devilreraser/hw_crypto_miner_bitfury/BitFury/Project Outputs for SHA256/BitFury BOM 2013 10 02.xls

Comment | Description | Designator | Footprint | LibRef | Quantity
Yellow SML210YT ROHM |  | D6 | SMD_0805_LED2012X100N | LED_2 | 1
SLC1480-201MLD |  | L1, L2 | SMD_INDM12501250X800A - Coilcraft SLC1480 | L | 2
Red SML210VT ROHM |  | D4 | SMD_0805_LED2012X100N | LED_2 | 1
Q4.000 MHz HC-49SM SMD | Crystal | Y1 | SMD_HC49_XTAL1140X480X420N | CRYSTAL | 1
Orange SML210DT ROHM |  | D7 | SMD_0805_LED2012X100N | LED_2 | 1
MCP2551-I/SN | CAN Driver | U21 | SMD_SOIC127P602X173-8N | MCP2551 | 1
LTC 4449 | Mosfet 12V Dual Bootstrapped PWM Sync Buck Optimised | U25, U30 | SMD_SOP65P490X110-9N - DUAL | DRVFET_LTC4442 | 2
L78M05CDT-TR |  | U20 | SMD_TO229P991X239-4AN_DPAK | IC_Vout1GND2Vin3 | 1
Green SML210MT ROHM |  | D5 | SMD_0805_LED2012X100N | LED_2 | 1
dsPIC33EP256MU806 |  | U1 | SMD_QFP50P1200X1200X120-64N | dsPIC33EP256MU806 | 1
CU04SCM15B0-R0 |  | J3 | SMD_CON-CVILUX-CU04-SCM15B0 | CON_USB_MINI_1 | 1
CON SIP2 | Connector | J4 | PTH_HDRV02W64P254_1X02 | CON2 | 1
CON MOLEX HDD |  | J2 | MOLEX_PWR_4P - AVALON | CON_4PINS | 1
CON FAN |  | J6 | PTH_CON_PANCON-MPSS100-04D | CON_4PINS | 1
CON CAN | Connector | J5 | PTH_CON_JST-B2PS-VH | CON2 | 1
BITFURY256 | BitFury SHA256 | U2, U3, U4, U5, U7, U8, U9, U10, U11, U12, U13, U14, U15, U16, U17, U18 | SMD_QFN50P700X700X90-49N | BITFURY256 | 16
BD33KA5WF |  | U19 | SMD_SOIC127P602X173-8N | IC_LM2931AD-5.0R2G_SO-8 | 1
BD18KA5WF |  | U24 | SMD_SOIC127P602X173-8N | IC_LM2931AD-5.0R2G_SO-8 | 1
BC817 |  | Q7, Q8 | SMD_SOT23_SOT95P240X120-3N | BJT_NPN_B1E2C3 | 2
BAT54C |  | D1, D2 | SMD_SOT23_SOT95P240X120-3N | D_DUAL_A1A2CC3 | 2
AP1RA03GMT-3 |  | Q1, Q2, Q3, Q4, Q5, Q6 | SMD_SON127P615X520X100-8N | MOS_N_D1_S1S2S3G4D5D6D7D8 | 6
768 | Resistor | R36 | SMD_0603_RESC1608X55N | Res3 | 1
470nF | Capacitor (Semiconductor SIM Model) | C2, C3, C4, C5, C6, C7, C8, C9, C11, C12, C13, C14, C15, C16, C18, C19, C20, C21, C22, C23, C24, C25, C26, C27, C28, C29, C30, C32, C33, C35, C36, C37, C39, C40, C41, C42, C43, C44, C46, C48, C49, C50, C51, C52, C53, C54, C55, C56, C57, C58, C60, C61, C62, C64, C66, C67, C68, C69, C70, C71, C77, C78, C79, C80, C81, C82, C83, C84, C87, C88, C89, C90, C91, C92, C93, C94, C95, C96, C97, C98, C100, C102, C103, C105, C106, C107, C108, C109, C110, C111, C112, C113, C114, C115, C116, C117, C118, C119, C120, C121, C122, C123, C124, C125, C126, C127, C128, C129, C130, C131, C132, C133, C134, C135, C136, C137, C138, C139, C140, C142, C144, C145, C146, C148, C149, C150, C152, C153, C154, C155, C156, C157, C158, C159, C160, C161, C162, C163, C164, C165, C166, C167, C169, C170, C171, C172, C173, C174, C175, C176, C177, C178, C179, C180, C181, C182, C183, C184, C185, C326, C327, C328, C329, C330, C331, C332, C333, C334, C335, C336, C337, C338, C339, C340, C341, C342, C343, C344, C345, C346, C347, C348, C349, C351, C352, C353, C355, C356, C388, C389, C390, C391, C392, C393, C394, C395, C396, C397, C398, C399, C400, C401, C402, C403, C404, C405, C406, C407, C408, C409, C410, C411, C412, C413, C414, C415, C416, C417, C418, C419, C420, C421, C422, C423, C424, C427, C428, C429, C430, C431, C432, C433, C434, C435, C436, C439, C440, C441, C442, C443, C444, C445, C446, C447, C448, C449, C450, C451, C452, C453, C454, C455, C456, C457, C458, C459, C460, C461, C462, C463, C464, C465, C466, C467, C4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 | SMD_0603_CAPC1608X80N | Cap Semi | 278
120 | Resistor | R41 | SMD_0603_RESC1608X55N | Res3 | 1
100pF | Capacitor | C253, C254 | SMD_0603_CAPC1608X80N | CAP | 2
100nF/50V | Capacitor | C189, C312 | SMD_0805_CAPC2012X145N | CAP | 2
100nF | Capacitor | C34, C72, C73, C74, C75, C76, C255 | SMD_0603_CAPC1608X80N | CAP | 7
27 | Resistor | R34, R35 | SMD_0603_RESC1608X55N | Res3 | 2
22uF/6.3V | Capacitor | C63, C198, C199, C200, C201, C202, C203, C204, C205, C206, C211, C220, C221, C222, C223, C224, C225, C226, C227, C229, C233, C234, C235, C236, C237, C240, C241, C242, C243, C244, C245, C246, C247, C248, C249, C250, C258, C259, C260, C261, C262, C283, C284, C285, C286, C287, C288, C289, C290, C291, C292, C293, C294, C295, C296, C297, C298, C299, C300, C301, C302, C303, C304, C305, C306, C314, C315, C316, C317, C318, C319, C320, C321, C322, C323, C324 | SMD_0805_CAPC2012X145N | CAP | 76
18pF | Capacitor | C85, C86 | SMD_0603_CAPC1608X80N | CAP | 2
10uF/16V | Capacitor | C17, C187, C188, C190, C191, C192, C193, C195, C196, C197, C207, C213, C214, C215, C216, C217, C218, C219, C231, C263, C264, C265, C266, C267, C268, C269, C270, C273, C274, C275, C276, C277, C278, C279, C280, C308 | SMD_0805_CAPC2012X145N | CAP | 36
10k | Resistor | R9, R40, R43, R44, R57, R59 | SMD_0603_RESC1608X55N | Res3 | 6
2.4k | Resistor | R37, R38, R45, R61 | SMD_0603_RESC1608X55N | Res3 | 4
2k | Resistor | R3, R4, R5, R6, R10, R11 | SMD_0603_RESC1608X55N | Res3 | 6
1uF/16V | Capacitor | C252, C311 | SMD_0805_CAPC2012X145N | CAP | 2
1uF | Capacitor | C209 | SMD_0805_CAPC2012X145N | CAP | 1
1nF | Capacitor | C251, C325 | SMD_0603_CAPC1608X80N | CAP | 2
1k | Resistor | R1, R2, R7, R8, R24, R25, R26, R27, R28, R29, R30, R31, R79, R80, R81, R82, R83, R84, R85, R86, R103, R104, R105, R106, R107, R108, R109, R110, R127, R128, R129, R130, R131, R132, R133, R134 | SMD_0603_RESC1608X55N | Res3 | 36
0 | Resistor | R12, R56, R63, R64 | SMD_0603_RESC1608X55N | Res3 | 4
0 | Resistor | R46, R47, R60 | SMD_1206_RESC3216X180N | Res3 | 3
(OPT)ТМ0J332M-RBJ21 | ТМ0J332M-RBJ21 | C228, C238, C239, C256, C257, C271, C282, C307, C309, C313 | PTH_CAPPR500-1300X2250 | C_POL | 10
(OPT) LM7805 |  | U22 | SMD_SOIC127P602X173-8N | IC_LM2931AD-5.0R2G_SO-8 | 1
(OPT) L7805CD2T-TR |  | U23 | SMD_TO254P1524X483-3_4N_D2PAK + DPAK | IC_Vout1GND2Vin3 | 1
(OPT)BU33TD3WG-TR |  | U6 | SMD_SOT26_SOT95P285X140-5N - DLV | VOLTREG LDO | 1
(OPT) BAV56 |  | D3 | SMD_SOT23_SOT95P240X120-3N | D_DUAL_A1A2CC3 | 1
(OPT)2200uF/16V |  | C208, C210, C272, C281 | PTH_CAPPR500-1300X2250 | C_POL | 4
(OPT)220uF | CL32A227MQVNNNE 220UF 6.3V 20% X5R 1210 | C358, C359, C360, C361, C362, C363, C364, C365, C366, C367, C368, C369, C370, C371, C372, C373, C374, C375, C376, C377, C378, C379, C380, C381, C382, C383, C384, C385, C386, C387, C503, C504, C505, C506, C507, C508, C509, C510, C511, C512, C513, C514, C515, C516, C517, C518, C519, C520, C521, C522, C523, C524, C525, C526, C527, C528, C529, C530, C531, C532, C533, C534, C535, C536 | SMD_1210_CAPC3225X279N | Cap Semi | 64
(OPT)100uF | CL32A227MQVNNNE 220UF 6.3V 20% X5R 1210 | C489, C491, C493, C494, C495, C501 | SMD_1210_CAPC3225X279N | Cap Semi | 6
(OPT)0 | Resistor | R13, R42, R62 | SMD_0603_RESC1608X55N | Res3 | 3
(OPT) CON PROGRAM | Connector | J1 | SIP5 PGM TOP | CON5 | 1
