devilreraser/hw_crypto_miner_bitfury/BTF16_2_2/PADS/73xxxx_PCB-Name_2Layers_PCB/3D/ImportedPartModels/pth_hdrv02w11060p500_1x02.stp

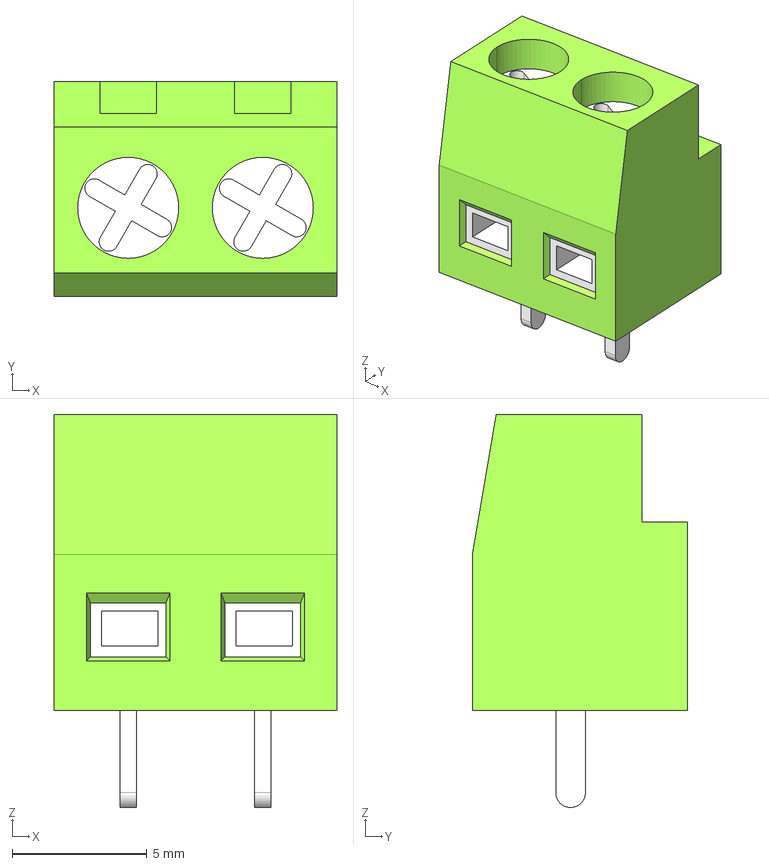
[picture p2: CAD file, 2024-01-20]
BTF16_2_2/PADS/73xxxx_PCB-Name_2Layers_PCB/3D/ImportedPartModels/pth_hdrv02w11060p500_1x02.stp
10.5 x 8.00 x 14.6 mm
