devilreraser/hw_crypto_miner_bitfury/BTF16_2_2/PADS/73xxxx_PCB-Name_2Layers_PCB/3D/ImportedPartModels/pth_hdrv05w64p254_1x05.stp

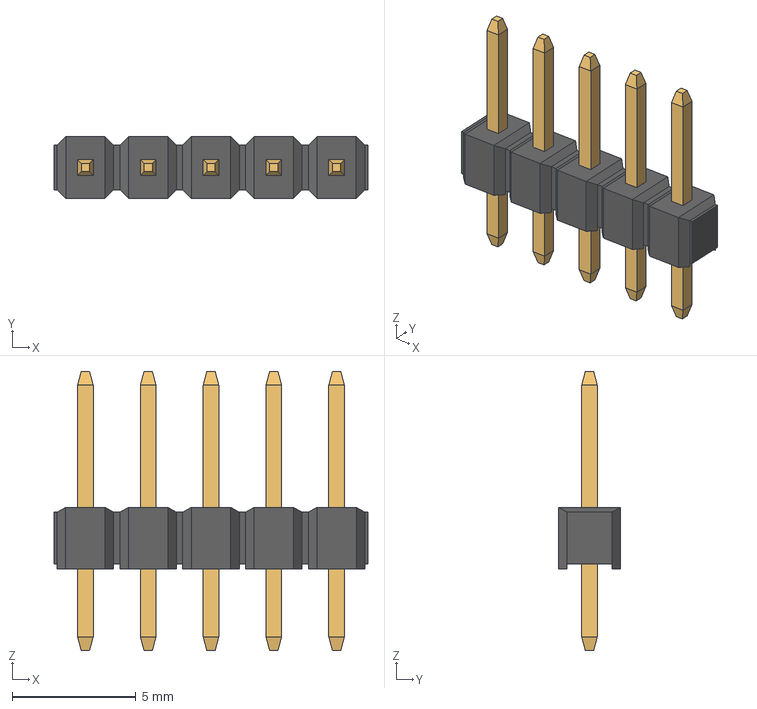
[picture p3: CAD file, 2024-01-20]
BTF16_2_2/PADS/73xxxx_PCB-Name_2Layers_PCB/3D/ImportedPartModels/pth_hdrv05w64p254_1x05.stp
12.7 x 2.50 x 11.3 mm
