devilreraser/hw_crypto_miner_bitfury/BTF16_2_2/PADS/73xxxx_PCB-Name_2Layers_PCB/3D/ImportedPartModels/SMD_LED2012X100N.stp

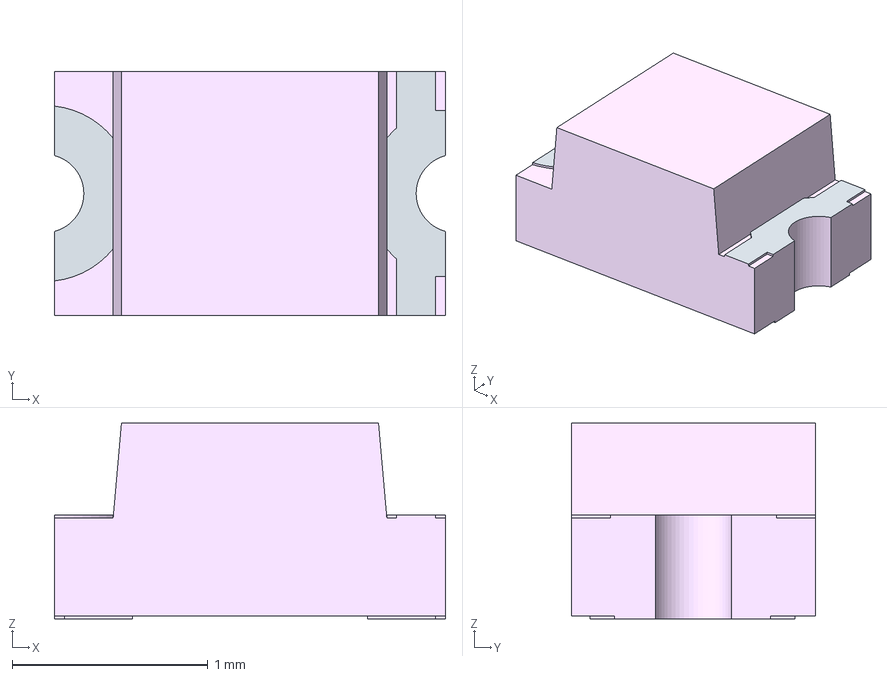
[picture p4: CAD file, 2024-01-20]
BTF16_2_2/PADS/73xxxx_PCB-Name_2Layers_PCB/3D/ImportedPartModels/SMD_LED2012X100N.stp
2.00 x 1.25 x 1.00 mm
