devilreraser/hw_crypto_miner_bitfury/BTF16_2_2/PADS/73xxxx_PCB-Name_2Layers_PCB/3D/ImportedPartModels/smd_soic127p1030x265-20n.stp

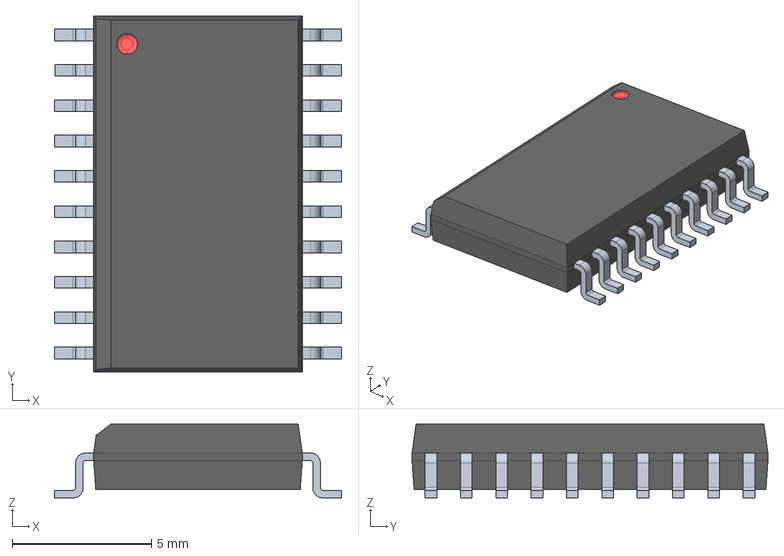
[picture p5: CAD file, 2024-01-20]
BTF16_2_2/PADS/73xxxx_PCB-Name_2Layers_PCB/3D/ImportedPartModels/smd_soic127p1030x265-20n.stp
10.3 x 12.8 x 2.65 mm
