devilreraser/hw_crypto_miner_bitfury/BTF16_2_2/PADS/73xxxx_PCB-Name_2Layers_PCB/3D/ImportedPartModels/smd_con-cvilux-cu04-scm15b0.stp

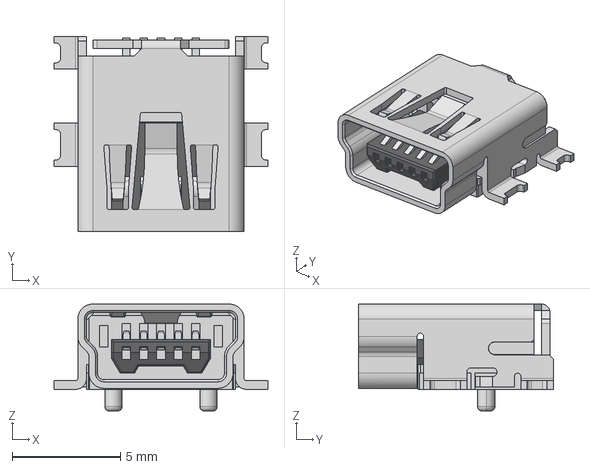
[picture p6: CAD file, 2024-01-20]
BTF16_2_2/PADS/73xxxx_PCB-Name_2Layers_PCB/3D/ImportedPartModels/smd_con-cvilux-cu04-scm15b0.stp
9.90 x 9.00 x 4.95 mm
