devilreraser/hw_crypto_miner_bitfury/BTF16_2_2/PADS/73xxxx_PCB-Name_2Layers_PCB/3D/ImportedPartModels/smd_0603_capc1608x80n.stp

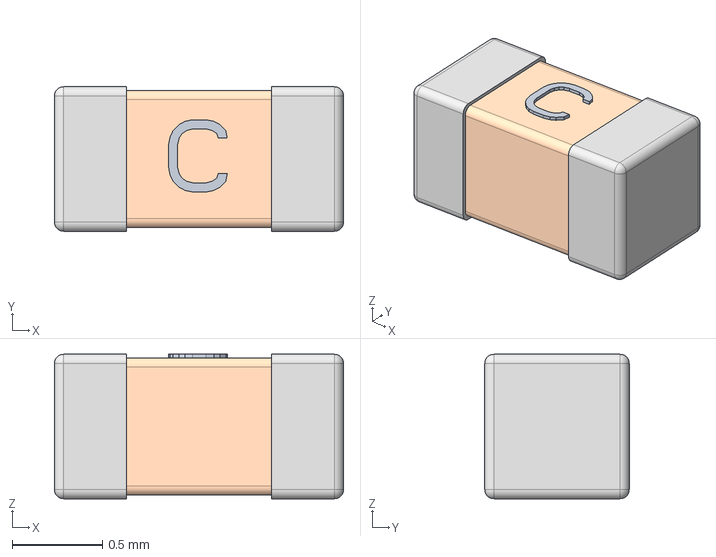
[picture p7: CAD file, 2024-01-20]
BTF16_2_2/PADS/73xxxx_PCB-Name_2Layers_PCB/3D/ImportedPartModels/smd_0603_capc1608x80n.stp
1.60 x 0.8 x 0.8 mm
