devilreraser/hw_crypto_miner_bitfury/BTF16_2_2/PADS/73xxxx_PCB-Name_2Layers_PCB/3D/ImportedPartModels/smd_0201_resc0603x26n.stp

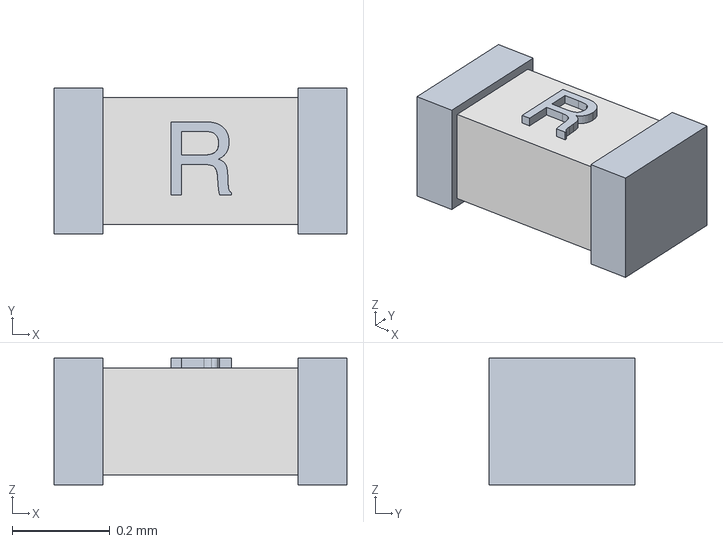
[picture p8: CAD file, 2024-01-20]
BTF16_2_2/PADS/73xxxx_PCB-Name_2Layers_PCB/3D/ImportedPartModels/smd_0201_resc0603x26n.stp
0.6 x 0.3 x 0.26 mm
