devilreraser/hw_crypto_miner_bitfury/BTF16_2_2/PADS/73xxxx_PCB-Name_2Layers_PCB/3D/ImportedPartModels/smd_sot457_sot95p275x110-6n.stp

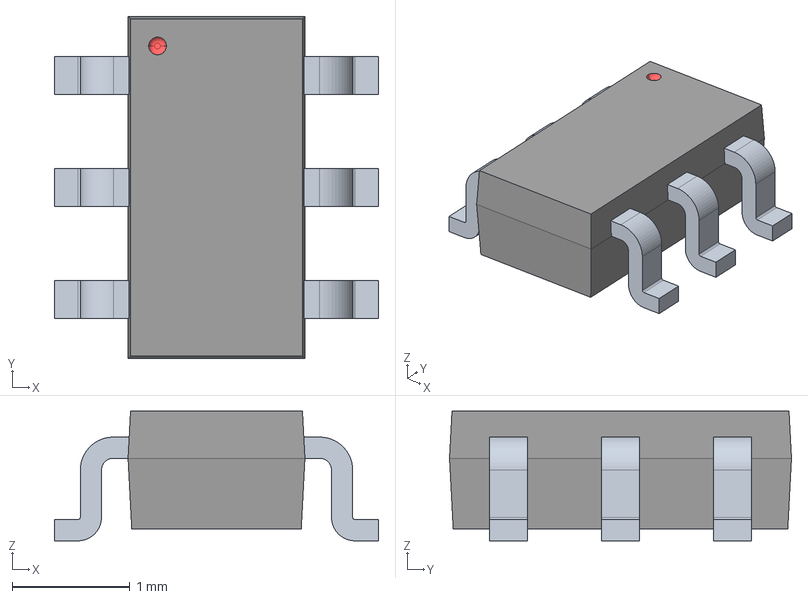
[picture p9: CAD file, 2024-01-20]
BTF16_2_2/PADS/73xxxx_PCB-Name_2Layers_PCB/3D/ImportedPartModels/smd_sot457_sot95p275x110-6n.stp
2.75 x 2.90 x 1.10 mm
