devilreraser/hw_crypto_miner_bitfury/(list of files, cad)

Other CAD files:
BitSyncom_avalon-ref/heatsink-a.dwg
