devilreraser/hw_crypto_miner_bitfury/NanoFury16/Project Outputs/2LayersPCBfull.PDF

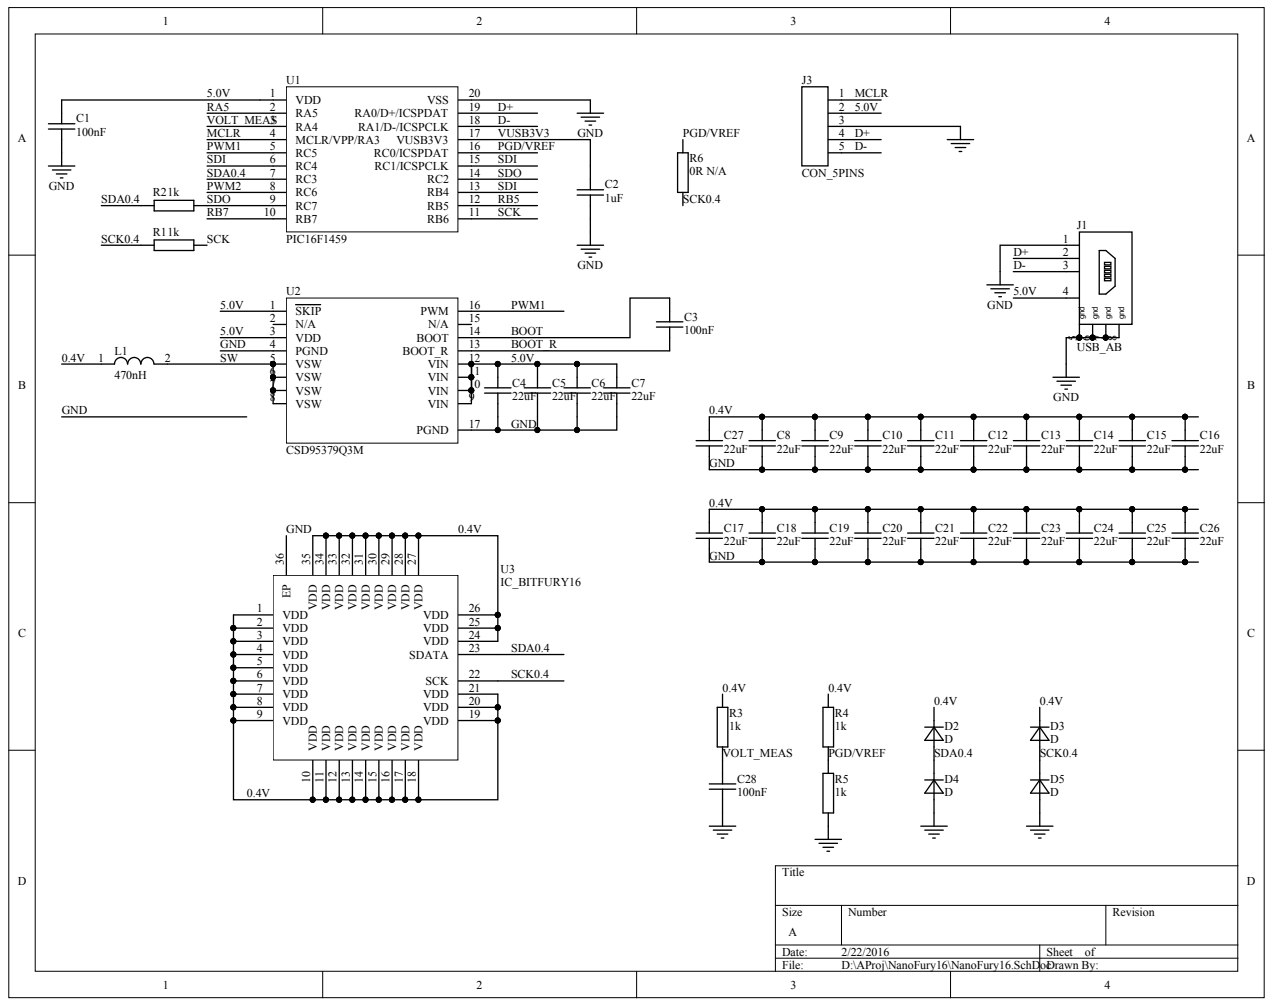
[picture p11: page 1]

D 18 VDD 19 VDD 20 VDD 21 SCK 22

Size A | Number | Revision

Date: 2/22/2016 | Sheet of
File: D:\AProj\NanoFury16\NanoFury16.SchDocDrawn By:

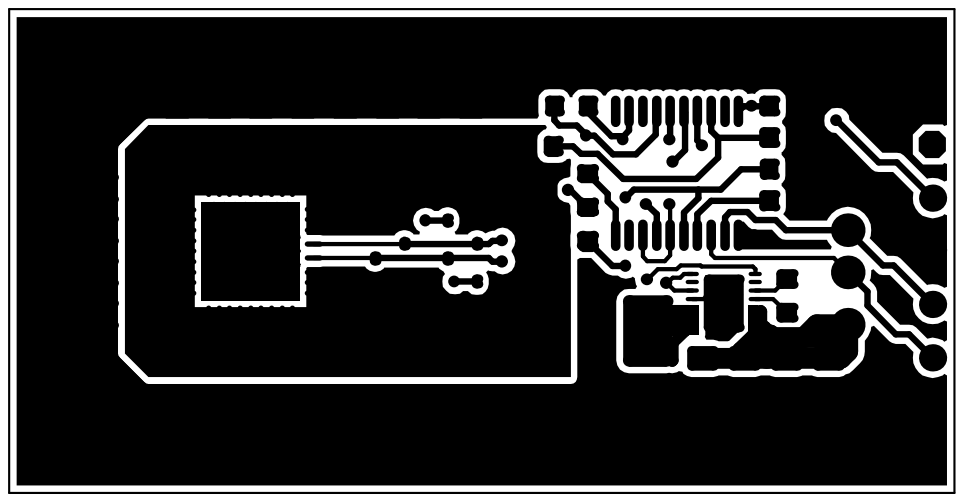
[picture p12: page 2]

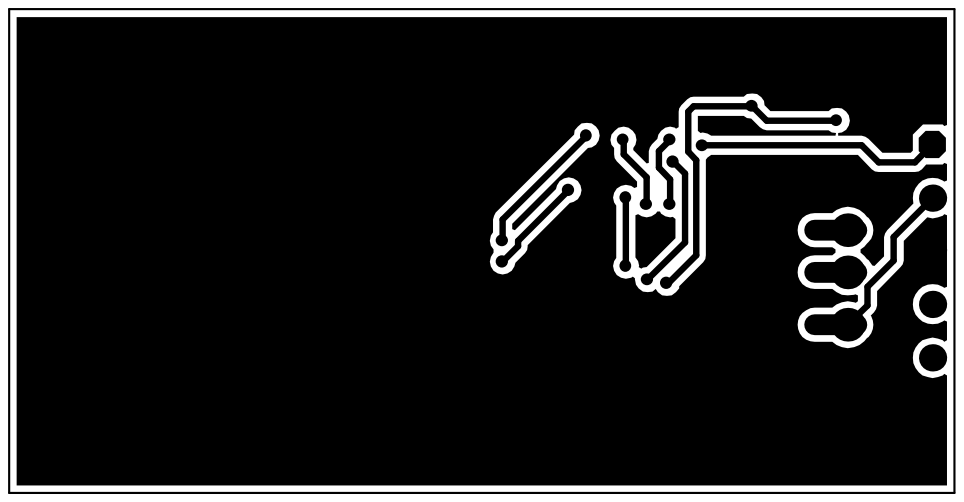
[picture p13: page 3]

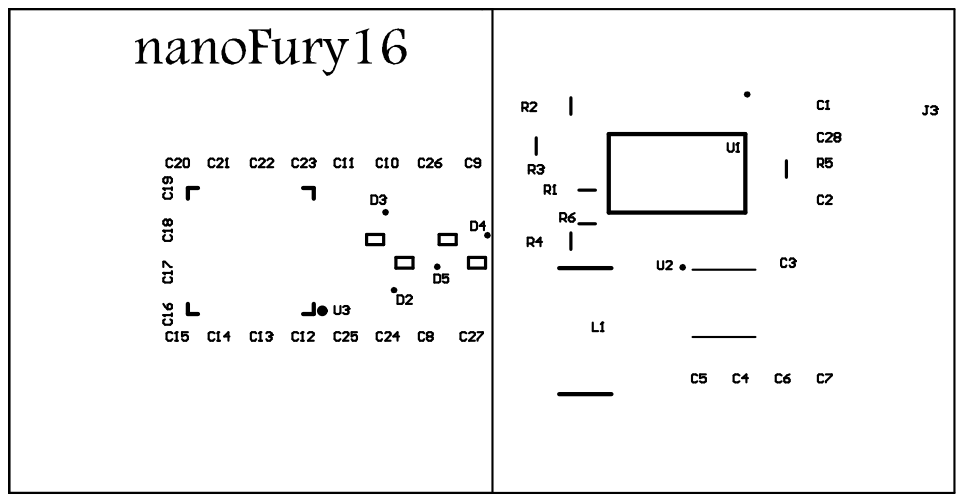
[picture p14: page 4]

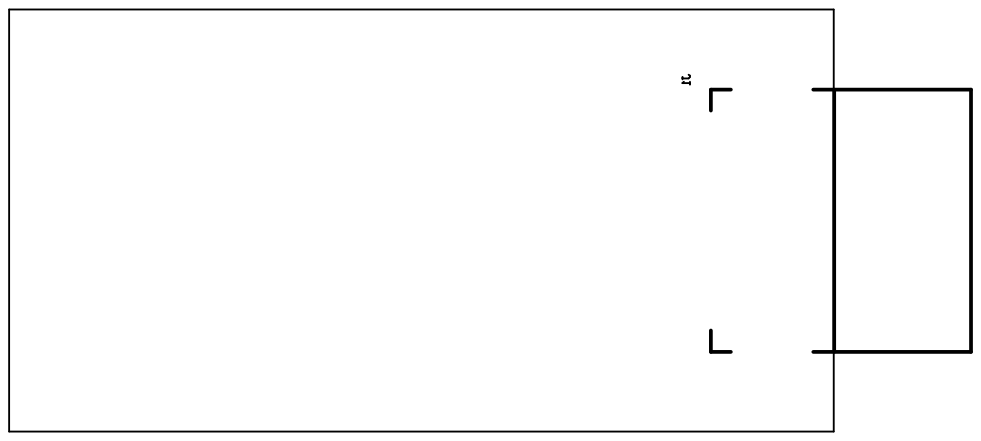
[picture p15: page 5]

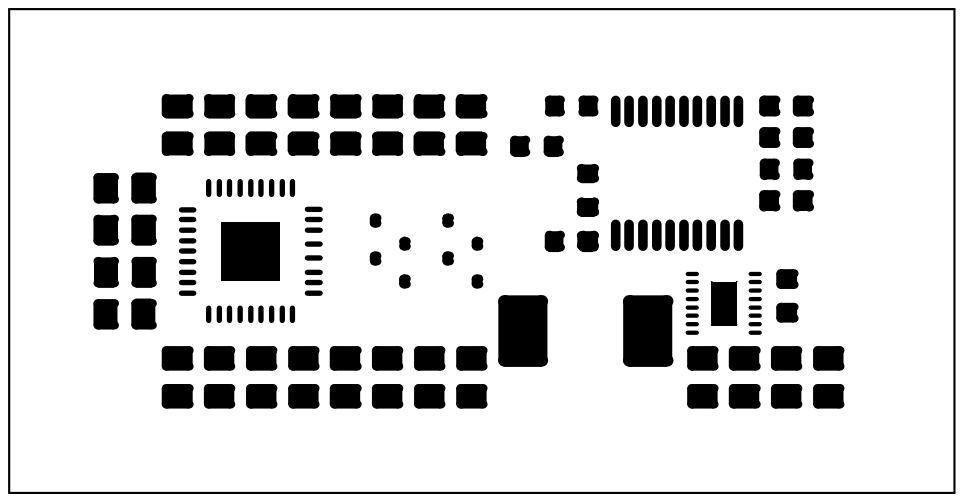
[picture p16: page 6]

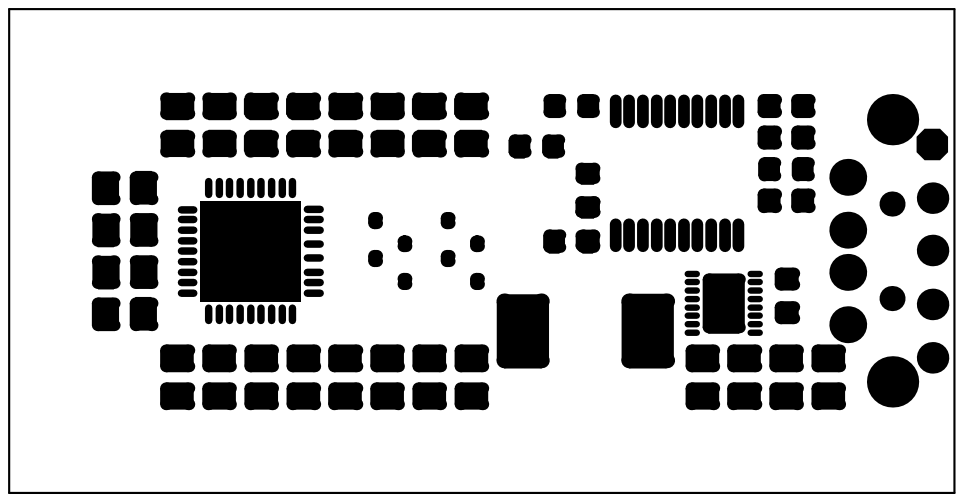
[picture p17: page 8]

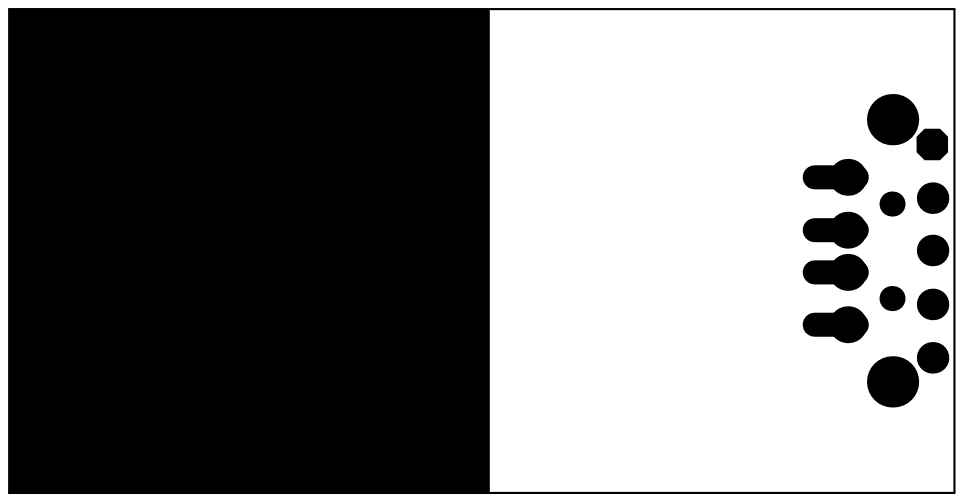
[picture p18: page 9]

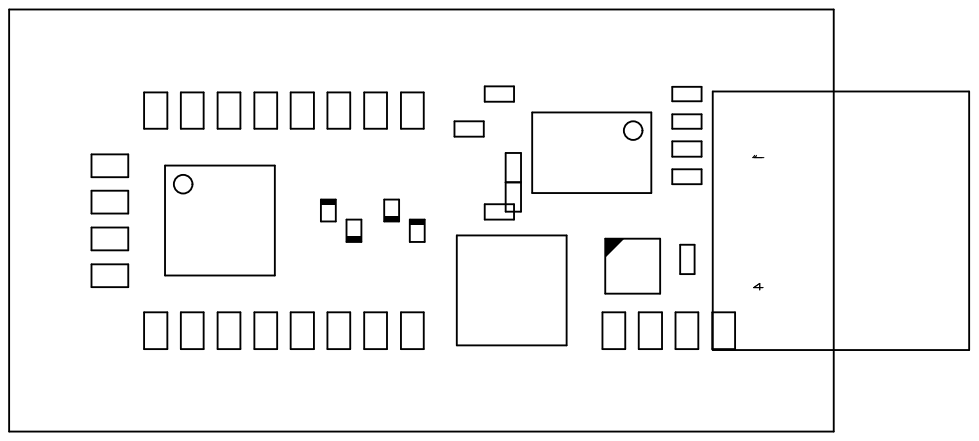
[picture p19: page 10]

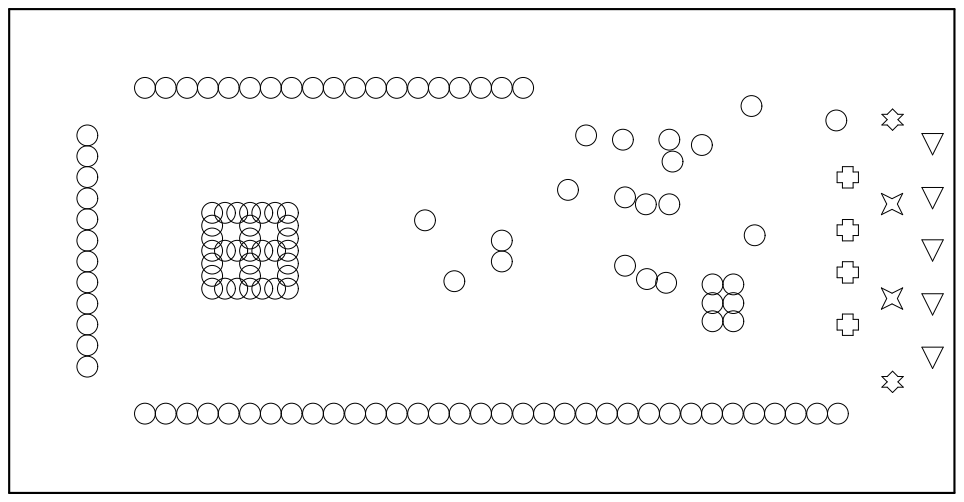
[picture p20: page 13]

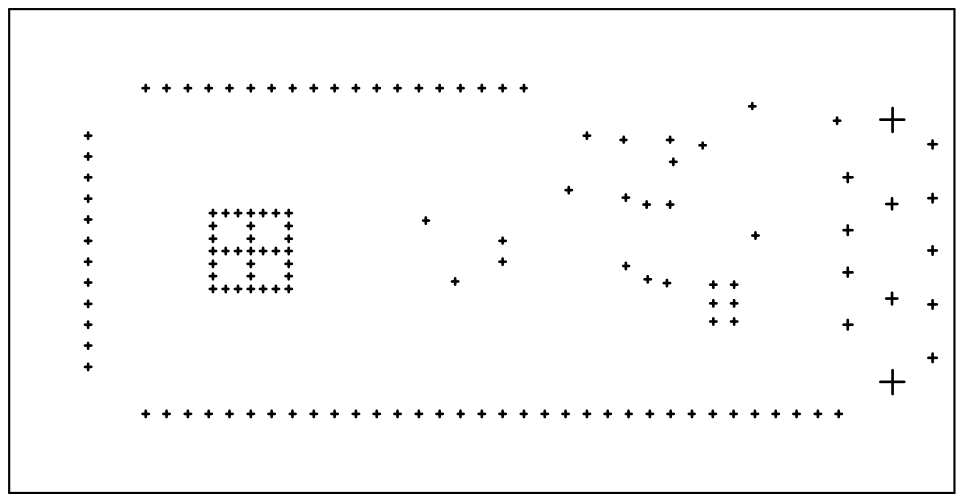
[picture p21: page 14]

Comment | Designator | Description | Footprint | Quantity
0R N/A | R6 | | SMD_0603_RESC1608X55N | 1
1k | R1, R2, R3, R4, R5 | | SMD_0603_RESC1608X55N | 5
1uF | C2 | | SMD_0603_CAPC1608X95N | 1
22uF | C4, C5, C6, C7, C8, C9, C10, C11, C12, C13, C14, C15, C16, C17, C18, C19, C20, C21, C22, C23, C24, C25, C26, C27 | | SMD_0805_CAPC2012X95N | 24
100nF | C1, C3, C28 | | SMD_0603_CAPC1608X95N | 3
470nH | L1 | | SMD_INDM720X665X300 | 1
CON_5PINS | J3 | | SIP5 - PGM | 1
CSD95379Q3M | U2 | Texas Instrumendts Buck Boost DC-DC | SMD_SON50P340X340X80-21N - VSON10 | 1
D | D2, D3, D4, D5 | | SMD_SOD523_SOD1608X65N | 4
IC_BITFURY16 | U3 | BitFury 2016 16 nm | SMD_QFN65P600X600X100-36AN | 1
PIC16F1459 | U1 | | SMD_SOP65P640X110-20N | 1
USB_AB | J1 | | PTH_CON_USB_FCI-87520-0010B-LF - MALE SMD PTH | 1
