devilreraser/hw_crypto_miner_bitfury/(list of files, drawings)

Other design files:
BitFury/BitFury.PrjPCB
BitFury/BitFury.SchDoc
BitSyncom_avalon-ref/Avalon_BP.SchDoc
BitSyncom_avalon-ref/Avalon_ctrlunit.PcbDoc
BitSyncom_avalon-ref/Avalon_ctrlunit.SchDoc
BitSyncom_avalon-ref/AVALON_hashunit_chip.SchDoc
BitSyncom_avalon-ref/AVALON_hashunit_power.SchDoc
BitSyncom_avalon-ref/Avalon_PDU.PcbDoc
BitSyncom_avalon-ref/Avalon_PDU.SchDoc
BTF16/ASIC.SchDoc
BTF16/BTF16.PrjPcb
BTF16/BTF16.SchDoc
BTF16/MCU.SchDoc
BTF16/POWER.SchDoc
BTF16_2/73xxxx_PCB-Name_2Layers.pcb
BTF16_2/73xxxx_PCB-Name_2Layers_Layou1.pcb
BTF16_2/ASIC_1.SchDoc
BTF16_2/ASIC_2.SchDoc
BTF16_2/ASIC_3.SchDoc
BTF16_2/Block.SchDoc
BTF16_2/BTF16_2.PrjPcb
BTF16_2/MCU.SchDoc
BTF16_2/POWER.SchDoc
BTF16_2_2/73xxxx_PCB-Name_2Layers.pcb
BTF16_2_2/73xxxx_PCB-Name_2Layers_Layou1.pcb
BTF16_2_2/ASIC_1.SchDoc
BTF16_2_2/ASIC_2.SchDoc
BTF16_2_2/ASIC_3.SchDoc
BTF16_2_2/Block.SchDoc
BTF16_2_2/BTF16_2.PrjPcb
BTF16_2_2/MCU.SchDoc
BTF16_2_2/PADS/73xxxx_PCB-Name_2Layers.pcb
BTF16_2_2/PADS/73xxxx_PCB-Name_2Layers_Layou1.pcb
BTF16_2_2/PADS/73xxxx_PCB-Name_2Layers_Layou2.pcb
BTF16_2_2/PADS/73xxxx_PCB-Name_2Layers_Layou3.pcb
BTF16_2_2/POWER.SchDoc
BTF16_2_rev.1/BTF16_2/ASIC_1.SchDoc
BTF16_2_rev.1/BTF16_2/ASIC_2.SchDoc
BTF16_2_rev.1/BTF16_2/ASIC_3.SchDoc
BTF16_2_rev.1/BTF16_2/Block.SchDoc
BTF16_2_rev.1/BTF16_2/BTF16_2.PrjPcb
BTF16_2_rev.1/BTF16_2/MCU.SchDoc
BTF16_2_rev.1/BTF16_2/Pads/BTF16_2_Rev01.pcb
BTF16_2_rev.1/BTF16_2/POWER.SchDoc
NanoFury16/NanoFury16.PcbDoc
NanoFury16/NanoFury16.PrjPcb
NanoFury16/NanoFury16.SchDoc
