devilreraser/hw_crypto_miner_bitfury/klondike-master/kicad/nano/nano.sch

## KiCad design klondike-master/kicad/nano/nano.sch (2024-01-20)

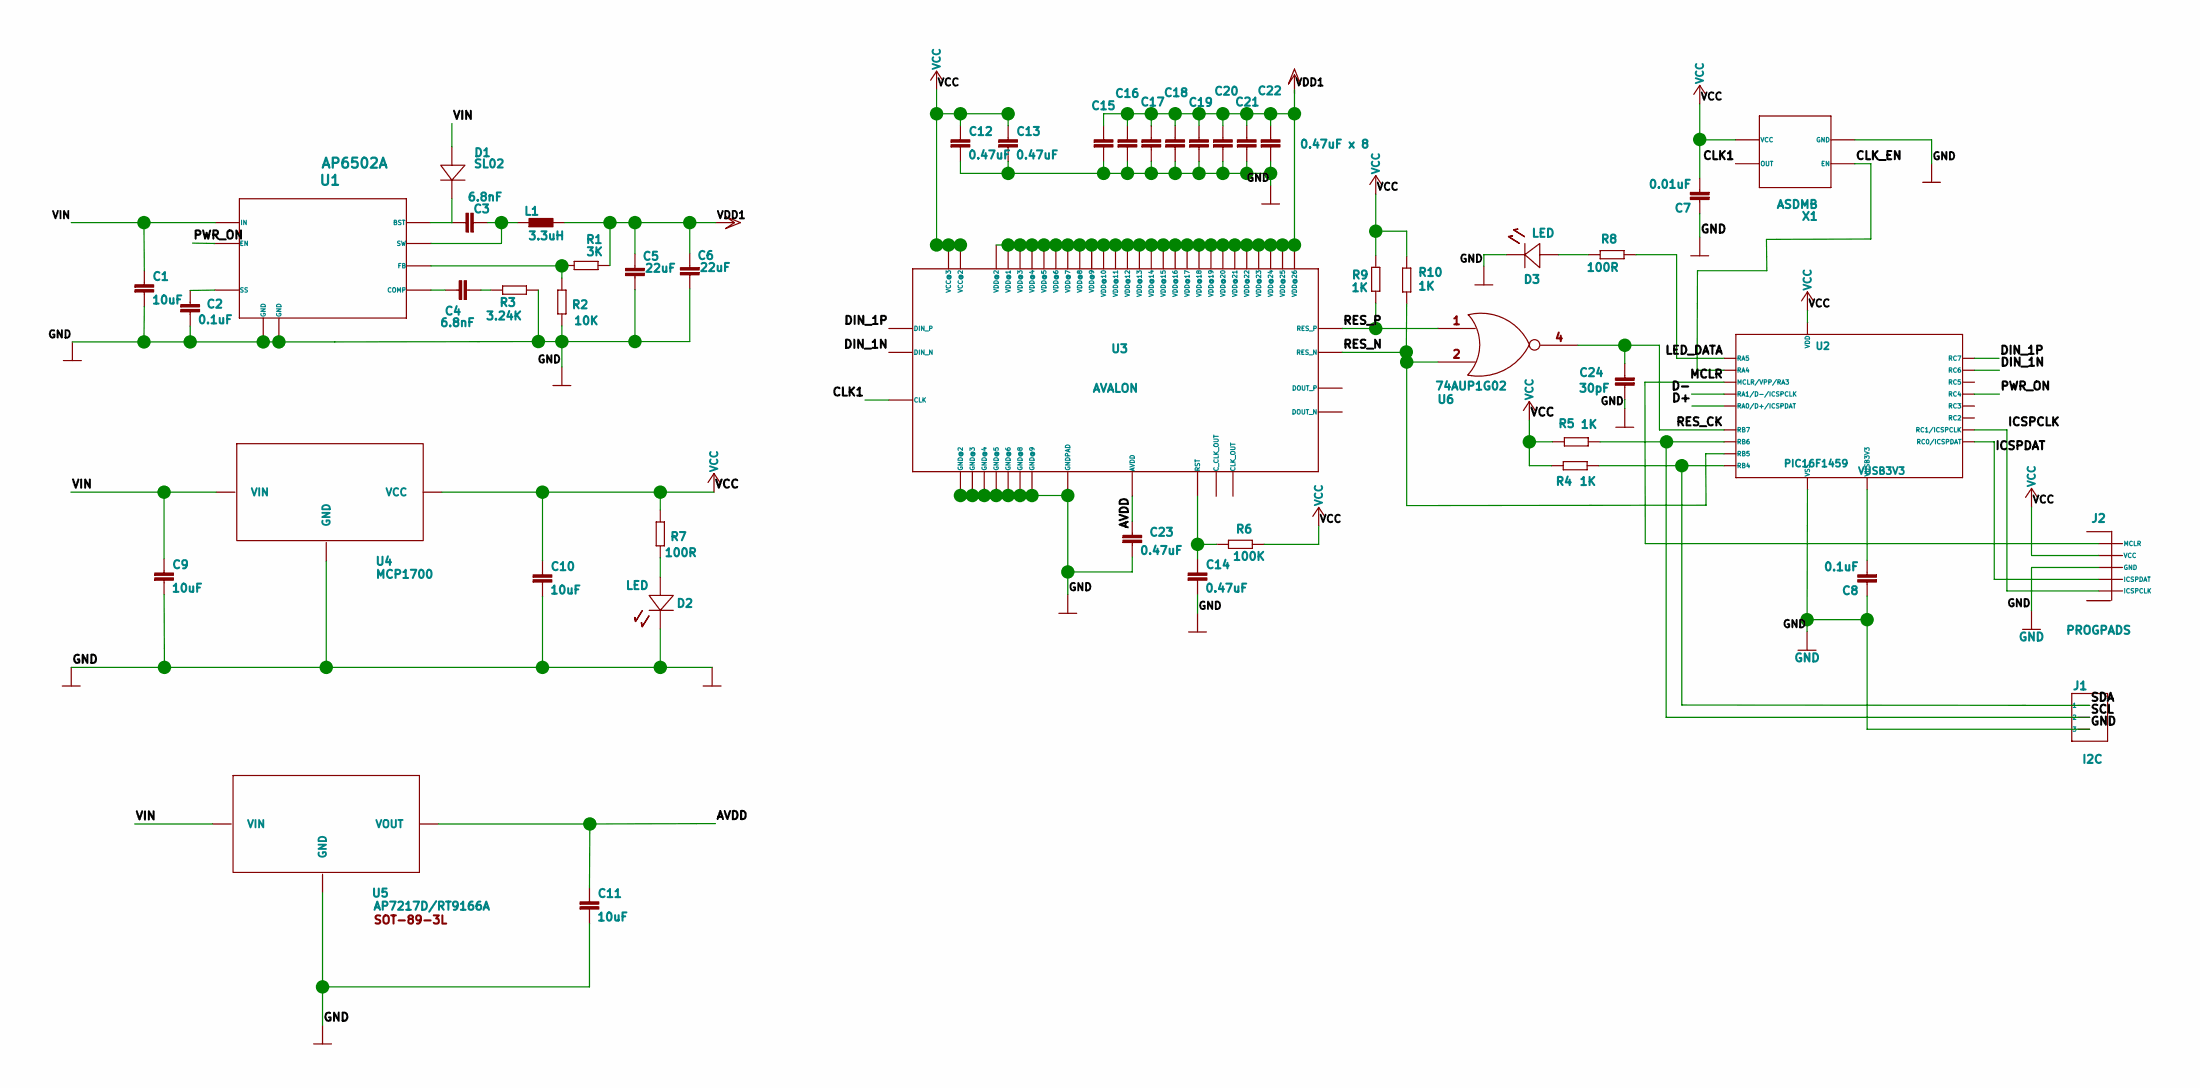
[picture p24: schematic nano.sch]

Parts:
C1, C9, C10, C11: 10uF
C2, C8: 0.1uF
C3, C4: 6.8nF
C5, C6: 22uF
C7: 0.01uF
C12, C13, C14, C15, C16, C17, C18, C19, C20, C21, C23: 0.47uF
C22: 0.47uF x 8
C24: 30pF
D1: SL02
D2, D3: LED
J1: I2C; pinhead-1X03
J2: PROGPADS
L1: 3.3uH
R1: 3K
R2: 10K
R3: 3.24K
R4, R5, R9, R10: 1K
R6: 100K
R7, R8: 100R
U1: AP6502A
U2: PIC16F1459
U3: AVALON
U4: MCP1700
U5: AP7217D/RT9166A
U6: 74AUP1G02
X1: ASDMB

Connections:
AVDD: C11.1, C23.1, U3.P$42 (AVDD), U5.3 (VOUT)
CLK1: U3.P$40 (CLK), X1.3 (OUT)
CLK_EN: U2.3 (RA4), X1.1 (EN)
D+: U2.19 (RA0/D+/ICSPDAT)
D-: U2.18 (RA1/D-/ICSPCLK)
DIN_1N: U2.8 (RC6), U3.P$47 (DIN_N)
DIN_1P: U2.9 (RC7), U3.P$48 (DIN_P)
GND: C1.2, C2.2, C5.1, C6.1, C7.1, C8.1, C9.2, C10.2, C11.2, C12.2, C13.2, C14.2, C15.2, C16.2, C17.2, C18.2, C19.2, C20.2, C21.2, C22.2, C23.2, C24.1, D2.2 (K), D3.2 (K), J1.3, J2.3 (GND), R2.1, R3.1, U1.4 (GND), U1.9 (GND), U2.20 (VSS), U3.GND (GNDPAD), U3.P$7 (GND@2), U3.P$11 (GND@3), U3.P$17 (GND@4), U3.P$26 (GND@5), U3.P$29 (GND@6), U3.P$41 (GND@8), U3.P$44 (GND@9), U4.1 (GND), U5.1 (GND), X1.2 (GND)
ICSPCLK: J2.5 (ICSPCLK), U2.15 (RC1/ICSPCLK)
ICSPDAT: J2.4 (ICSPDAT), U2.16 (RC0/ICSPDAT)
LED_DATA: R8.1, U2.2 (RA5)
MCLR: J2.1 (MCLR), U2.4 (MCLR/VPP/RA3)
unnamed: C2.1, U1.8 (SS)
unnamed: C3.1, D1.2 (K), U1.1 (BST)
unnamed: C3.2, L1.1, U1.3 (SW)
unnamed: C4.1, U1.6 (COMP)
unnamed: C4.2, R3.2
unnamed: C8.2, U2.17 (VUSB3V3)
unnamed: C14.1, R6.2, U3.P$4 (RST)
unnamed: D2.1 (A), R7.1
unnamed: D3.1 (A), R8.2
unnamed: R1.2, R2.2, U1.5 (FB)
PWR_ON: U1.7 (EN), U2.6 (RC4)
RES_CK: C24.2, U2.10 (RB7), U6.4
RES_N: R10.2, U2.12 (RB5), U3.P$32 (RES_N), U6.2
RES_P: R9.2, U3.P$31 (RES_P), U6.1
SCL: J1.2, R5.1, U2.11 (RB6)
SDA: J1.1, R4.1, U2.13 (RB4)
VCC: C7.2, C10.1, C12.1, C13.1, J2.2 (VCC), R4.2, R5.2, R6.1, R7.2, R9.1, R10.1, U2.1 (VDD), U3.P$12 (VCC@3), U3.P$25 (VCC@2), U4.2 (VCC), X1.4 (VCC)
VDD1: C5.2, C6.2, C15.1, C16.1, C17.1, C18.1, C19.1, C20.1, C21.1, C22.1, L1.2, R1.1, U3.P$1 (VDD@1), U3.P$2 (VDD@2), U3.P$3 (VDD@3), U3.P$6 (VDD@4), U3.P$8 (VDD@5), U3.P$9 (VDD@6), U3.P$10 (VDD@7), U3.P$15 (VDD@8), U3.P$16 (VDD@9), U3.P$18 (VDD@10), U3.P$21 (VDD@11), U3.P$22 (VDD@12), U3.P$23 (VDD@13), U3.P$24 (VDD@14), U3.P$27 (VDD@15), U3.P$28 (VDD@16), U3.P$30 (VDD@17), U3.P$33 (VDD@18), U3.P$34 (VDD@19), U3.P$35 (VDD@20), U3.P$36 (VDD@21), U3.P$37 (VDD@22), U3.P$38 (VDD@23), U3.P$43 (VDD@24), U3.P$45 (VDD@25), U3.P$46 (VDD@26)
VIN: C1.1, C9.1, D1.1 (A), U1.2 (IN), U4.3 (VIN), U5.2 (VIN)
