devilreraser/hw_crypto_miner_bitfury/klondike-master/kicad/k16/k16.sch

## KiCad design klondike-master/kicad/k16/k16.sch (2024-01-20)



Parts:
C1, C20: 1.0uF
C2, C21: 2.2uF
C3, C22: 100pF
C4, C5, C6, C7, C8, C23, C24, C25, C26, C27, C41, C42: 10uF
C9, C10, C11, C28, C29, C30, C267: 0.1uF
C12, C13, C14, C15, C31, C32, C33, C34: 47uF
C16, C35: 3.3nF
C17, C36: 10nF
C18, C37: 220pF
C19, C273: 330uF
C38: 22nF
C39, C40, C268, C269, C270, C271: 22uF
C43, C44, C45, C47, C48, C49, C50, C51, C52, C53, C55, C59, C60, C61, C62, C63, C64, C65, C66, C67, C68, C70, C73, C74, C75, C76, C77, C78, C79, C80, C81, C82, C84, C87, C88, C89, C90, C91, C92, C93, C94, C95, C96, C98, C99, C100, C101, C102, C103, C104, C105, C106, C107, C108, C110, C113, C114, C115, C116, C117, C118, C119, C120, C121, C122, C124, C127, C128, C129, C130, C131, C132, C133, C134, C135, C136, C138, C141, C142, C143, C144, C145, C146, C147, C148, C149, C150, C152, C155, C156, C157, C158, C159, C160, C161, C162, C163, C164, C166, C169, C170, C171, C172, C173, C174, C175, C176, C177, C178, C180, C183, C184, C185, C186, C187, C188, C189, C190, C191, C192, C194, C197, C198, C199, C200, C201, C202, C203, C204, C205, C206, C208, C211, C212, C213, C214, C215, C216, C217, C218, C219, C220, C222, C225, C226, C227, C228, C229, C230, C231, C232, C233, C234, C236, C239, C240, C241, C242, C243, C244, C245, C246, C247, C248, C250, C253, C254, C255, C256, C257, C258, C259, C260, C261, C262, C264: 0.47uF
C54, C69, C83, C97, C123, C137, C151, C165, C179, C193, C207, C221, C235, C249, C263: 0.47uF x 8
C109: 0.47uF x8
C272: 0.01uF
C274: 30pF
D1, D2: LED
J1: PCIEPWR
J2, J4: (no value)
J3, J5: PINHD-1X4; pinhead-1X04
L1, L2: 0.36uH
L3: L0805
PRG1: (no value)
Q1: NDS351AN
R1, R11: 39.2K
R2, R12: 7.5K
R3, R4, R13, R14: 49.9K
R5, R9, R15, R19: 4.02K
R6, R16, R22, R43, R44, R47: 100R
R7, R10, R17, R20: 2.87K
R8, R18: 1.78K
R21: 10K
R23, R42, R45, R46: 1K
R24, R25: 2.2K
R26, R27, R28, R29, R30, R31, R32, R33, R34, R35, R36, R37, R38, R39, R40, R41: 100K
RT1: 2.2K
U1, U2, U3, U4, U5, U6, U7, U8, U9, U10, U11, U12, U13, U14, U15, U16: AVALON
U17: PIC16LF1459
U18, U19: IR3895
U20: MCP16321
U21: NL27WZ14
U22, U23: AP7217D / RT9166A
U24: 74AUP1G02
X1: ASMDB

Connections:
+12V: C1.2, C4.1, C5.1, C6.1, C7.1, C8.1, C9.1, C19.+, C20.2, C23.1, C24.1, C25.1, C26.1, C27.1, C28.1, C41.1, C42.1, C273.+, J1.1, J1.2, J1.3, J4.2, R3.2, R13.2, U18.9 (VIN), U18.13 (PVIN), U19.9 (VIN), U19.13 (PVIN), U20.2 (VIN@2), U20.3 (VIN@3), U20.11 (VIN@11)
AVDD1: C55.1, C70.1, C84.1, C98.1, C110.1, C124.1, C138.1, C152.1, C271.1, U1.P$42 (AVDD), U2.P$42 (AVDD), U3.P$42 (AVDD), U4.P$42 (AVDD), U5.P$42 (AVDD), U6.P$42 (AVDD), U7.P$42 (AVDD), U8.P$42 (AVDD), U23.3 (VOUT)
AVDD2: C166.1, C180.1, C194.1, C208.1, C222.1, C236.1, C250.1, C264.1, C269.1, U9.P$42 (AVDD), U10.P$42 (AVDD), U11.P$42 (AVDD), U12.P$42 (AVDD), U13.P$42 (AVDD), U14.P$42 (AVDD), U15.P$42 (AVDD), U16.P$42 (AVDD), U22.3 (VOUT)
CLK1: U1.P$40 (CLK), U2.P$40 (CLK), U3.P$40 (CLK), U4.P$40 (CLK), U5.P$40 (CLK), U6.P$40 (CLK), U7.P$40 (CLK), U8.P$40 (CLK), U21.4 (Y2)
CLK2: U9.P$40 (CLK), U10.P$40 (CLK), U11.P$40 (CLK), U12.P$40 (CLK), U13.P$40 (CLK), U14.P$40 (CLK), U15.P$40 (CLK), U16.P$40 (CLK), U21.6 (Y1)
CLK_EN: U17.3 (RA4), X1.1 (EN)
DIN_1N: U1.P$47 (DIN_N), U4.P$14 (DOUT_N)
DIN_1P: U1.P$48 (DIN_P), U4.P$13 (DOUT_P)
DIN_2N: U2.P$47 (DIN_N), U7.P$14 (DOUT_N)
DIN_2P: U2.P$48 (DIN_P), U7.P$13 (DOUT_P)
DIN_3N: U1.P$14 (DOUT_N), U3.P$47 (DIN_N)
DIN_3P: U1.P$13 (DOUT_P), U3.P$48 (DIN_P)
DIN_4N: U2.P$14 (DOUT_N), U4.P$47 (DIN_N)
DIN_4P: U2.P$13 (DOUT_P), U4.P$48 (DIN_P)
DIN_5N: U5.P$47 (DIN_N), U8.P$14 (DOUT_N)
DIN_5P: U5.P$48 (DIN_P), U8.P$13 (DOUT_P)
DIN_6N: U6.P$47 (DIN_N), U17.8 (RC6)
DIN_6P: U6.P$48 (DIN_P), U17.9 (RC7)
DIN_7N: U5.P$14 (DOUT_N), U7.P$47 (DIN_N)
DIN_7P: U5.P$13 (DOUT_P), U7.P$48 (DIN_P)
DIN_8N: U6.P$14 (DOUT_N), U8.P$47 (DIN_N)
DIN_8P: U6.P$13 (DOUT_P), U8.P$48 (DIN_P)
DIN_9N: U9.P$47 (DIN_N), U17.7 (RC3)
DIN_9P: U9.P$48 (DIN_P), U17.6 (RC4)
DIN_10N: U10.P$47 (DIN_N), U11.P$14 (DOUT_N)
DIN_10P: U10.P$48 (DIN_P), U11.P$13 (DOUT_P)
DIN_11N: U9.P$14 (DOUT_N), U11.P$47 (DIN_N)
DIN_11P: U9.P$13 (DOUT_P), U11.P$48 (DIN_P)
DIN_12N: U10.P$14 (DOUT_N), U12.P$47 (DIN_N)
DIN_12P: U10.P$13 (DOUT_P), U12.P$48 (DIN_P)
DIN_13N: U12.P$14 (DOUT_N), U13.P$47 (DIN_N)
DIN_13P: U12.P$13 (DOUT_P), U13.P$48 (DIN_P)
DIN_14N: U14.P$47 (DIN_N), U15.P$14 (DOUT_N)
DIN_14P: U14.P$48 (DIN_P), U15.P$13 (DOUT_P)
DIN_15N: U13.P$14 (DOUT_N), U15.P$47 (DIN_N)
DIN_15P: U13.P$13 (DOUT_P), U15.P$48 (DIN_P)
DIN_16N: U14.P$14 (DOUT_N), U16.P$47 (DIN_N)
DIN_16P: U14.P$13 (DOUT_P), U16.P$48 (DIN_P)
FANGND: J4.1, Q1.1 (D)
GND: C1.1, C2.2, C3.2, C4.2, C5.2, C6.2, C7.2, C8.2, C9.2, C11.2, C12.2, C13.2, C14.2, C15.2, C19.-, C20.1, C21.2, C22.2, C23.2, C24.2, C25.2, C26.2, C27.2, C28.2, C30.2, C31.2, C32.2, C33.2, C34.2, C39.2, C40.2, C41.2, C42.2, C43.2, C44.2, C45.2, C47.2, C48.2, C49.2, C50.2, C51.2, C52.2, C53.2, C54.2, C55.2, C59.2, C60.2, C61.2, C62.2, C63.2, C64.2, C65.2, C66.2, C67.2, C68.2, C69.2, C70.2, C73.2, C74.2, C75.2, C76.2, C77.2, C78.2, C79.2, C80.2, C81.2, C82.2, C83.2, C84.2, C87.2, C88.2, C89.2, C90.2, C91.2, C92.2, C93.2, C94.2, C95.2, C96.2, C97.2, C98.2, C99.2, C100.2, C101.2, C102.2, C103.2, C104.2, C105.2, C106.2, C107.2, C108.2, C109.2, C110.2, C113.2, C114.2, C115.2, C116.2, C117.2, C118.2, C119.2, C120.2, C121.2, C122.2, C123.2, C124.2, C127.2, C128.2, C129.2, C130.2, C131.2, C132.2, C133.2, C134.2, C135.2, C136.2, C137.2, C138.2, C141.2, C142.2, C143.2, C144.2, C145.2, C146.2, C147.2, C148.2, C149.2, C150.2, C151.2, C152.2, C155.2, C156.2, C157.2, C158.2, C159.2, C160.2, C161.2, C162.2, C163.2, C164.2, C165.2, C166.2, C169.2, C170.2, C171.2, C172.2, C173.2, C174.2, C175.2, C176.2, C177.2, C178.2, C179.2, C180.2, C183.2, C184.2, C185.2, C186.2, C187.2, C188.2, C189.2, C190.2, C191.2, C192.2, C193.2, C194.2, C197.2, C198.2, C199.2, C200.2, C201.2, C202.2, C203.2, C204.2, C205.2, C206.2, C207.2, C208.2, C211.2, C212.2, C213.2, C214.2, C215.2, C216.2, C217.2, C218.2, C219.2, C220.2, C221.2, C222.2, C225.2, C226.2, C227.2, C228.2, C229.2, C230.2, C231.2, C232.2, C233.2, C234.2, C235.2, C236.2, C239.2, C240.2, C241.2, C242.2, C243.2, C244.2, C245.2, C246.2, C247.2, C248.2, C249.2, C250.2, C253.2, C254.2, C255.2, C256.2, C257.2, C258.2, C259.2, C260.2, C261.2, C262.2, C263.2, C264.2, C267.1, C268.2, C269.2, C270.2, C271.2, C272.2, C273.-, C274.1, J1.4, J1.5, J1.6, J2.5 (GND), J2.S1 (GND), J2.S2 (GND), J2.S3 (GND), J2.S4 (GND), J3.1, J5.2, PRG1.3 (GND), Q1.2 (S), R1.1, R2.1, R7.1, R10.1, R11.1, R12.1, R17.1, R20.1, R42.2, R43.2, R44.2, U1.GND (GNDPAD), U1.P$7 (GND@2), U1.P$11 (GND@3), U1.P$17 (GND@4), U1.P$26 (GND@5), U1.P$29 (GND@6), U1.P$41 (GND@8), U1.P$44 (GND@9), U2.GND (GNDPAD), U2.P$7 (GND@2), U2.P$11 (GND@3), U2.P$17 (GND@4), U2.P$26 (GND@5), U2.P$29 (GND@6), U2.P$41 (GND@8), U2.P$44 (GND@9), U3.GND (GNDPAD), U3.P$7 (GND@2), U3.P$11 (GND@3), U3.P$17 (GND@4), U3.P$26 (GND@5), U3.P$29 (GND@6), U3.P$41 (GND@8), U3.P$44 (GND@9), U4.GND (GNDPAD), U4.P$7 (GND@2), U4.P$11 (GND@3), U4.P$17 (GND@4), U4.P$26 (GND@5), U4.P$29 (GND@6), U4.P$41 (GND@8), U4.P$44 (GND@9), U5.GND (GNDPAD), U5.P$7 (GND@2), U5.P$11 (GND@3), U5.P$17 (GND@4), U5.P$26 (GND@5), U5.P$29 (GND@6), U5.P$41 (GND@8), U5.P$44 (GND@9), U6.GND (GNDPAD), U6.P$7 (GND@2), U6.P$11 (GND@3), U6.P$17 (GND@4), U6.P$26 (GND@5), U6.P$29 (GND@6), U6.P$41 (GND@8), U6.P$44 (GND@9), U7.GND (GNDPAD), U7.P$7 (GND@2), U7.P$11 (GND@3), U7.P$17 (GND@4), U7.P$26 (GND@5), U7.P$29 (GND@6), U7.P$41 (GND@8), U7.P$44 (GND@9), U8.GND (GNDPAD), U8.P$7 (GND@2), U8.P$11 (GND@3), U8.P$17 (GND@4), U8.P$26 (GND@5), U8.P$29 (GND@6), U8.P$41 (GND@8), U8.P$44 (GND@9), U9.GND (GNDPAD), U9.P$7 (GND@2), U9.P$11 (GND@3), U9.P$17 (GND@4), U9.P$26 (GND@5), U9.P$29 (GND@6), U9.P$41 (GND@8), U9.P$44 (GND@9), U10.GND (GNDPAD), U10.P$7 (GND@2), U10.P$11 (GND@3), U10.P$17 (GND@4), U10.P$26 (GND@5), U10.P$29 (GND@6), U10.P$41 (GND@8), U10.P$44 (GND@9), U11.GND (GNDPAD), U11.P$7 (GND@2), U11.P$11 (GND@3), U11.P$17 (GND@4), U11.P$26 (GND@5), U11.P$29 (GND@6), U11.P$41 (GND@8), U11.P$44 (GND@9), U12.GND (GNDPAD), U12.P$7 (GND@2), U12.P$11 (GND@3), U12.P$17 (GND@4), U12.P$26 (GND@5), U12.P$29 (GND@6), U12.P$41 (GND@8), U12.P$44 (GND@9), U13.GND (GNDPAD), U13.P$7 (GND@2), U13.P$11 (GND@3), U13.P$17 (GND@4), U13.P$26 (GND@5), U13.P$29 (GND@6), U13.P$41 (GND@8), U13.P$44 (GND@9), U14.GND (GNDPAD), U14.P$7 (GND@2), U14.P$11 (GND@3), U14.P$17 (GND@4), U14.P$26 (GND@5), U14.P$29 (GND@6), U14.P$41 (GND@8), U14.P$44 (GND@9), U15.GND (GNDPAD), U15.P$7 (GND@2), U15.P$11 (GND@3), U15.P$17 (GND@4), U15.P$26 (GND@5), U15.P$29 (GND@6), U15.P$41 (GND@8), U15.P$44 (GND@9), U16.GND (GNDPAD), U16.P$7 (GND@2), U16.P$11 (GND@3), U16.P$17 (GND@4), U16.P$26 (GND@5), U16.P$29 (GND@6), U16.P$41 (GND@8), U16.P$44 (GND@9), U17.20 (VSS), U18.4 (GND@4), U18.11 (PGND), U18.17 (GND@17), U19.4 (GND@4), U19.11 (PGND), U19.17 (GND@17), U20.4 (SGND), U20.14 (PGND@14), U20.15 (PGND@15), U20.17 (PGND@17), U22.1 (GND), U23.1 (GND), X1.2 (GND)
ICSPCLK: PRG1.5 (ICSPCLK), U17.15 (RC1/ICSPCLK)
ICSPDAT: PRG1.4 (ICSPDAT), U17.16 (RC0/ICSPDAT)
LED_DATA: D1.1 (A), U17.2 (RA5)
MCLR: PRG1.1 (MCLR), R22.2, U17.4 (MCLR/VPP/RA3)
unnamed: C2.1, R4.2, U18.6 (S_CTRL), U18.10 (VCC/LDO_OUT)
unnamed: C3.1, U18.2 (VREF)
unnamed: C10.1, U18.14 (BOOT)
unnamed: C16.2, R6.2
unnamed: C17.1, C18.1, U18.3 (COMP)
unnamed: C17.2, R8.1
unnamed: C18.2, R5.2, R6.1, R7.2, R8.2, U18.1 (FB)
unnamed: C21.1, R14.2, U19.6 (S_CTRL), U19.10 (VCC/LDO_OUT)
unnamed: C22.1, U19.2 (VREF)
unnamed: C29.1, U19.14 (BOOT)
unnamed: C35.2, R16.2
unnamed: C36.1, C37.1, U19.3 (COMP)
unnamed: C36.2, R18.1
unnamed: C37.2, R15.2, R16.1, R17.2, R18.2, U19.1 (FB)
unnamed: C38.1, U20.10 (BOOST)
unnamed: C45.1, R26.1, U1.P$4 (RST)
unnamed: C61.1, R30.1, U2.P$4 (RST)
unnamed: C75.1, R34.1, U3.P$4 (RST)
unnamed: C89.1, R38.1, U4.P$4 (RST)
unnamed: C101.1, R27.1, U5.P$4 (RST)
unnamed: C115.1, R31.1, U6.P$4 (RST)
unnamed: C129.1, R35.1, U7.P$4 (RST)
unnamed: C143.1, R39.1, U8.P$4 (RST)
unnamed: C157.1, R28.1, U9.P$4 (RST)
unnamed: C171.1, R32.1, U10.P$4 (RST)
unnamed: C185.1, R36.1, U11.P$4 (RST)
unnamed: C199.1, R40.1, U12.P$4 (RST)
unnamed: C213.1, R29.1, U13.P$4 (RST)
unnamed: C227.1, R33.1, U14.P$4 (RST)
unnamed: C241.1, R37.1, U15.P$4 (RST)
unnamed: C255.1, R41.1, U16.P$4 (RST)
unnamed: C267.2, U17.17 (VUSB3V3)
unnamed: D1.2 (K), R44.1
unnamed: D2.2 (K), R43.1
unnamed: J2.2 (D-), U17.18 (RA1/D-/ICSPCLK)
unnamed: J2.3 (D+), U17.19 (RA0/D+/ICSPDAT)
unnamed: Q1.3 (G), U17.5 (RC5)
unnamed: R1.2, U18.5 (RT/SYNC)
unnamed: R2.2, R3.1, U18.15 (ENABLE)
unnamed: R4.1, U18.7 (PGOOD)
unnamed: R9.1, R10.2, U18.8 (VSNS)
unnamed: R11.2, U19.5 (RT/SYNC)
unnamed: R12.2, R13.1, U19.15 (ENABLE)
unnamed: R14.1, U19.7 (PGOOD)
unnamed: R19.1, R20.2, U19.8 (VSNS)
unnamed: R21.1, U20.8 (PG)
unnamed: R47.1, U24.4
unnamed: U21.1 (A1), U21.3 (A2), X1.3 (OUT)
RES_CK: C274.2, R47.2, U17.10 (RB7)
RES_N: R46.2, U1.P$32 (RES_N), U2.P$32 (RES_N), U3.P$32 (RES_N), U4.P$32 (RES_N), U5.P$32 (RES_N), U6.P$32 (RES_N), U7.P$32 (RES_N), U8.P$32 (RES_N), U9.P$32 (RES_N), U10.P$32 (RES_N), U11.P$32 (RES_N), U12.P$32 (RES_N), U13.P$32 (RES_N), U14.P$32 (RES_N), U15.P$32 (RES_N), U16.P$32 (RES_N), U17.12 (RB5), U24.2
RES_P: R45.2, U1.P$31 (RES_P), U2.P$31 (RES_P), U3.P$31 (RES_P), U4.P$31 (RES_P), U5.P$31 (RES_P), U6.P$31 (RES_P), U7.P$31 (RES_P), U8.P$31 (RES_P), U9.P$31 (RES_P), U10.P$31 (RES_P), U11.P$31 (RES_P), U12.P$31 (RES_P), U13.P$31 (RES_P), U14.P$31 (RES_P), U15.P$31 (RES_P), U16.P$31 (RES_P), U24.1
SCL: J3.3, J5.4, R25.2, U17.11 (RB6)
SDA: J3.4, J5.3, R24.2, U17.13 (RB4)
SW1: C10.2, L1.1, U18.12 (SW)
SW2: C29.2, L2.1, U19.12 (SW)
SW3: C38.2, L3.1, U20.1 (SW@1), U20.12 (SW@12), U20.13 (SW@13), U20.16 (SW@16)
TACH: J4.3, R22.1, R23.2
THERM: R42.1, RT1.2, U17.14 (RC2)
VCC: C39.1, C40.1, C43.1, C44.1, C59.1, C60.1, C73.1, C74.1, C87.1, C88.1, C99.1, C100.1, C113.1, C114.1, C127.1, C128.1, C141.1, C142.1, C155.1, C156.1, C169.1, C170.1, C183.1, C184.1, C197.1, C198.1, C211.1, C212.1, C225.1, C226.1, C239.1, C240.1, C253.1, C254.1, C268.1, C270.1, C272.1, D2.1 (A), J3.2, J5.1, L3.2, PRG1.2 (VCC), R21.2, R23.1, R24.1, R25.1, R26.2, R27.2, R28.2, R29.2, R30.2, R31.2, R32.2, R33.2, R34.2, R35.2, R36.2, R37.2, R38.2, R39.2, R40.2, R41.2, R45.1, R46.1, RT1.1, U1.P$12 (VCC@3), U1.P$25 (VCC@2), U2.P$12 (VCC@3), U2.P$25 (VCC@2), U3.P$12 (VCC@3), U3.P$25 (VCC@2), U4.P$12 (VCC@3), U4.P$25 (VCC@2), U5.P$12 (VCC@3), U5.P$25 (VCC@2), U6.P$12 (VCC@3), U6.P$25 (VCC@2), U7.P$12 (VCC@3), U7.P$25 (VCC@2), U8.P$12 (VCC@3), U8.P$25 (VCC@2), U9.P$12 (VCC@3), U9.P$25 (VCC@2), U10.P$12 (VCC@3), U10.P$25 (VCC@2), U11.P$12 (VCC@3), U11.P$25 (VCC@2), U12.P$12 (VCC@3), U12.P$25 (VCC@2), U13.P$12 (VCC@3), U13.P$25 (VCC@2), U14.P$12 (VCC@3), U14.P$25 (VCC@2), U15.P$12 (VCC@3), U15.P$25 (VCC@2), U16.P$12 (VCC@3), U16.P$25 (VCC@2), U17.1 (VDD), U20.5 (FB), U22.2 (VIN), U23.2 (VIN), X1.4 (VCC)
VDD1: C11.1, C12.1, C13.1, C14.1, C15.1, C16.1, C47.1, C48.1, C49.1, C50.1, C51.1, C52.1, C53.1, C54.1, C62.1, C63.1, C64.1, C65.1, C66.1, C67.1, C68.1, C69.1, C76.1, C77.1, C78.1, C79.1, C80.1, C81.1, C82.1, C83.1, C90.1, C91.1, C92.1, C93.1, C94.1, C95.1, C96.1, C97.1, C102.1, C103.1, C104.1, C105.1, C106.1, C107.1, C108.1, C109.1, C116.1, C117.1, C118.1, C119.1, C120.1, C121.1, C122.1, C123.1, C130.1, C131.1, C132.1, C133.1, C134.1, C135.1, C136.1, C137.1, C144.1, C145.1, C146.1, C147.1, C148.1, C149.1, C150.1, C151.1, L1.2, R5.1, R9.2, U1.P$1 (VDD@1), U1.P$2 (VDD@2), U1.P$3 (VDD@3), U1.P$6 (VDD@4), U1.P$8 (VDD@5), U1.P$9 (VDD@6), U1.P$10 (VDD@7), U1.P$15 (VDD@8), U1.P$16 (VDD@9), U1.P$18 (VDD@10), U1.P$21 (VDD@11), U1.P$22 (VDD@12), U1.P$23 (VDD@13), U1.P$24 (VDD@14), U1.P$27 (VDD@15), U1.P$28 (VDD@16), U1.P$30 (VDD@17), U1.P$33 (VDD@18), U1.P$34 (VDD@19), U1.P$35 (VDD@20), U1.P$36 (VDD@21), U1.P$37 (VDD@22), U1.P$38 (VDD@23), U1.P$43 (VDD@24), U1.P$45 (VDD@25), U1.P$46 (VDD@26), U2.P$1 (VDD@1), U2.P$2 (VDD@2), U2.P$3 (VDD@3), U2.P$6 (VDD@4), U2.P$8 (VDD@5), U2.P$9 (VDD@6), U2.P$10 (VDD@7), U2.P$15 (VDD@8), U2.P$16 (VDD@9), U2.P$18 (VDD@10), U2.P$21 (VDD@11), U2.P$22 (VDD@12), U2.P$23 (VDD@13), U2.P$24 (VDD@14), U2.P$27 (VDD@15), U2.P$28 (VDD@16), U2.P$30 (VDD@17), U2.P$33 (VDD@18), U2.P$34 (VDD@19), U2.P$35 (VDD@20), U2.P$36 (VDD@21), U2.P$37 (VDD@22), U2.P$38 (VDD@23), U2.P$43 (VDD@24), U2.P$45 (VDD@25), U2.P$46 (VDD@26), U3.P$1 (VDD@1), U3.P$2 (VDD@2), U3.P$3 (VDD@3), U3.P$6 (VDD@4), U3.P$8 (VDD@5), U3.P$9 (VDD@6), U3.P$10 (VDD@7), U3.P$15 (VDD@8), U3.P$16 (VDD@9), U3.P$18 (VDD@10), U3.P$21 (VDD@11), U3.P$22 (VDD@12), U3.P$23 (VDD@13), U3.P$24 (VDD@14), U3.P$27 (VDD@15), U3.P$28 (VDD@16), U3.P$30 (VDD@17), U3.P$33 (VDD@18), U3.P$34 (VDD@19), U3.P$35 (VDD@20), U3.P$36 (VDD@21), U3.P$37 (VDD@22), U3.P$38 (VDD@23), U3.P$43 (VDD@24), U3.P$45 (VDD@25), U3.P$46 (VDD@26), U4.P$1 (VDD@1), U4.P$2 (VDD@2), U4.P$3 (VDD@3), U4.P$6 (VDD@4), U4.P$8 (VDD@5), U4.P$9 (VDD@6), U4.P$10 (VDD@7), U4.P$15 (VDD@8), U4.P$16 (VDD@9), U4.P$18 (VDD@10), U4.P$21 (VDD@11), U4.P$22 (VDD@12), U4.P$23 (VDD@13), U4.P$24 (VDD@14), U4.P$27 (VDD@15), U4.P$28 (VDD@16), U4.P$30 (VDD@17), U4.P$33 (VDD@18), U4.P$34 (VDD@19), U4.P$35 (VDD@20), U4.P$36 (VDD@21), U4.P$37 (VDD@22), U4.P$38 (VDD@23), U4.P$43 (VDD@24), U4.P$45 (VDD@25), U4.P$46 (VDD@26), U5.P$1 (VDD@1), U5.P$2 (VDD@2), U5.P$3 (VDD@3), U5.P$6 (VDD@4), U5.P$8 (VDD@5), U5.P$9 (VDD@6), U5.P$10 (VDD@7), U5.P$15 (VDD@8), U5.P$16 (VDD@9), U5.P$18 (VDD@10), U5.P$21 (VDD@11), U5.P$22 (VDD@12), U5.P$23 (VDD@13), U5.P$24 (VDD@14), U5.P$27 (VDD@15), U5.P$28 (VDD@16), U5.P$30 (VDD@17), U5.P$33 (VDD@18), U5.P$34 (VDD@19), U5.P$35 (VDD@20), U5.P$36 (VDD@21), U5.P$37 (VDD@22), U5.P$38 (VDD@23), U5.P$43 (VDD@24), U5.P$45 (VDD@25), U5.P$46 (VDD@26), U6.P$1 (VDD@1), U6.P$2 (VDD@2), U6.P$3 (VDD@3), U6.P$6 (VDD@4), U6.P$8 (VDD@5), U6.P$9 (VDD@6), U6.P$10 (VDD@7), U6.P$15 (VDD@8), U6.P$16 (VDD@9), U6.P$18 (VDD@10), U6.P$21 (VDD@11), U6.P$22 (VDD@12), U6.P$23 (VDD@13), U6.P$24 (VDD@14), U6.P$27 (VDD@15), U6.P$28 (VDD@16), U6.P$30 (VDD@17), U6.P$33 (VDD@18), U6.P$34 (VDD@19), U6.P$35 (VDD@20), U6.P$36 (VDD@21), U6.P$37 (VDD@22), U6.P$38 (VDD@23), U6.P$43 (VDD@24), U6.P$45 (VDD@25), U6.P$46 (VDD@26), U7.P$1 (VDD@1), U7.P$2 (VDD@2), U7.P$3 (VDD@3), U7.P$6 (VDD@4), U7.P$8 (VDD@5), U7.P$9 (VDD@6), U7.P$10 (VDD@7), U7.P$15 (VDD@8), U7.P$16 (VDD@9), U7.P$18 (VDD@10), U7.P$21 (VDD@11), U7.P$22 (VDD@12), U7.P$23 (VDD@13), U7.P$24 (VDD@14), U7.P$27 (VDD@15), U7.P$28 (VDD@16), U7.P$30 (VDD@17), U7.P$33 (VDD@18), U7.P$34 (VDD@19), U7.P$35 (VDD@20), U7.P$36 (VDD@21), U7.P$37 (VDD@22), U7.P$38 (VDD@23), U7.P$43 (VDD@24), U7.P$45 (VDD@25), U7.P$46 (VDD@26), U8.P$1 (VDD@1), U8.P$2 (VDD@2), U8.P$3 (VDD@3), U8.P$6 (VDD@4), U8.P$8 (VDD@5), U8.P$9 (VDD@6), U8.P$10 (VDD@7), U8.P$15 (VDD@8), U8.P$16 (VDD@9), U8.P$18 (VDD@10), U8.P$21 (VDD@11), U8.P$22 (VDD@12), U8.P$23 (VDD@13), U8.P$24 (VDD@14), U8.P$27 (VDD@15), U8.P$28 (VDD@16), U8.P$30 (VDD@17), U8.P$33 (VDD@18), U8.P$34 (VDD@19), U8.P$35 (VDD@20), U8.P$36 (VDD@21), U8.P$37 (VDD@22), U8.P$38 (VDD@23), U8.P$43 (VDD@24), U8.P$45 (VDD@25), U8.P$46 (VDD@26)
VDD2: C30.1, C31.1, C32.1, C33.1, C34.1, C35.1, C158.1, C159.1, C160.1, C161.1, C162.1, C163.1, C164.1, C165.1, C172.1, C173.1, C174.1, C175.1, C176.1, C177.1, C178.1, C179.1, C186.1, C187.1, C188.1, C189.1, C190.1, C191.1, C192.1, C193.1, C200.1, C201.1, C202.1, C203.1, C204.1, C205.1, C206.1, C207.1, C214.1, C215.1, C216.1, C217.1, C218.1, C219.1, C220.1, C221.1, C228.1, C229.1, C230.1, C231.1, C232.1, C233.1, C234.1, C235.1, C242.1, C243.1, C244.1, C245.1, C246.1, C247.1, C248.1, C249.1, C256.1, C257.1, C258.1, C259.1, C260.1, C261.1, C262.1, C263.1, L2.2, R15.1, R19.2, U9.P$1 (VDD@1), U9.P$2 (VDD@2), U9.P$3 (VDD@3), U9.P$6 (VDD@4), U9.P$8 (VDD@5), U9.P$9 (VDD@6), U9.P$10 (VDD@7), U9.P$15 (VDD@8), U9.P$16 (VDD@9), U9.P$18 (VDD@10), U9.P$21 (VDD@11), U9.P$22 (VDD@12), U9.P$23 (VDD@13), U9.P$24 (VDD@14), U9.P$27 (VDD@15), U9.P$28 (VDD@16), U9.P$30 (VDD@17), U9.P$33 (VDD@18), U9.P$34 (VDD@19), U9.P$35 (VDD@20), U9.P$36 (VDD@21), U9.P$37 (VDD@22), U9.P$38 (VDD@23), U9.P$43 (VDD@24), U9.P$45 (VDD@25), U9.P$46 (VDD@26), U10.P$1 (VDD@1), U10.P$2 (VDD@2), U10.P$3 (VDD@3), U10.P$6 (VDD@4), U10.P$8 (VDD@5), U10.P$9 (VDD@6), U10.P$10 (VDD@7), U10.P$15 (VDD@8), U10.P$16 (VDD@9), U10.P$18 (VDD@10), U10.P$21 (VDD@11), U10.P$22 (VDD@12), U10.P$23 (VDD@13), U10.P$24 (VDD@14), U10.P$27 (VDD@15), U10.P$28 (VDD@16), U10.P$30 (VDD@17), U10.P$33 (VDD@18), U10.P$34 (VDD@19), U10.P$35 (VDD@20), U10.P$36 (VDD@21), U10.P$37 (VDD@22), U10.P$38 (VDD@23), U10.P$43 (VDD@24), U10.P$45 (VDD@25), U10.P$46 (VDD@26), U11.P$1 (VDD@1), U11.P$2 (VDD@2), U11.P$3 (VDD@3), U11.P$6 (VDD@4), U11.P$8 (VDD@5), U11.P$9 (VDD@6), U11.P$10 (VDD@7), U11.P$15 (VDD@8), U11.P$16 (VDD@9), U11.P$18 (VDD@10), U11.P$21 (VDD@11), U11.P$22 (VDD@12), U11.P$23 (VDD@13), U11.P$24 (VDD@14), U11.P$27 (VDD@15), U11.P$28 (VDD@16), U11.P$30 (VDD@17), U11.P$33 (VDD@18), U11.P$34 (VDD@19), U11.P$35 (VDD@20), U11.P$36 (VDD@21), U11.P$37 (VDD@22), U11.P$38 (VDD@23), U11.P$43 (VDD@24), U11.P$45 (VDD@25), U11.P$46 (VDD@26), U12.P$1 (VDD@1), U12.P$2 (VDD@2), U12.P$3 (VDD@3), U12.P$6 (VDD@4), U12.P$8 (VDD@5), U12.P$9 (VDD@6), U12.P$10 (VDD@7), U12.P$15 (VDD@8), U12.P$16 (VDD@9), U12.P$18 (VDD@10), U12.P$21 (VDD@11), U12.P$22 (VDD@12), U12.P$23 (VDD@13), U12.P$24 (VDD@14), U12.P$27 (VDD@15), U12.P$28 (VDD@16), U12.P$30 (VDD@17), U12.P$33 (VDD@18), U12.P$34 (VDD@19), U12.P$35 (VDD@20), U12.P$36 (VDD@21), U12.P$37 (VDD@22), U12.P$38 (VDD@23), U12.P$43 (VDD@24), U12.P$45 (VDD@25), U12.P$46 (VDD@26), U13.P$1 (VDD@1), U13.P$2 (VDD@2), U13.P$3 (VDD@3), U13.P$6 (VDD@4), U13.P$8 (VDD@5), U13.P$9 (VDD@6), U13.P$10 (VDD@7), U13.P$15 (VDD@8), U13.P$16 (VDD@9), U13.P$18 (VDD@10), U13.P$21 (VDD@11), U13.P$22 (VDD@12), U13.P$23 (VDD@13), U13.P$24 (VDD@14), U13.P$27 (VDD@15), U13.P$28 (VDD@16), U13.P$30 (VDD@17), U13.P$33 (VDD@18), U13.P$34 (VDD@19), U13.P$35 (VDD@20), U13.P$36 (VDD@21), U13.P$37 (VDD@22), U13.P$38 (VDD@23), U13.P$43 (VDD@24), U13.P$45 (VDD@25), U13.P$46 (VDD@26), U14.P$1 (VDD@1), U14.P$2 (VDD@2), U14.P$3 (VDD@3), U14.P$6 (VDD@4), U14.P$8 (VDD@5), U14.P$9 (VDD@6), U14.P$10 (VDD@7), U14.P$15 (VDD@8), U14.P$16 (VDD@9), U14.P$18 (VDD@10), U14.P$21 (VDD@11), U14.P$22 (VDD@12), U14.P$23 (VDD@13), U14.P$24 (VDD@14), U14.P$27 (VDD@15), U14.P$28 (VDD@16), U14.P$30 (VDD@17), U14.P$33 (VDD@18), U14.P$34 (VDD@19), U14.P$35 (VDD@20), U14.P$36 (VDD@21), U14.P$37 (VDD@22), U14.P$38 (VDD@23), U14.P$43 (VDD@24), U14.P$45 (VDD@25), U14.P$46 (VDD@26), U15.P$1 (VDD@1), U15.P$2 (VDD@2), U15.P$3 (VDD@3), U15.P$6 (VDD@4), U15.P$8 (VDD@5), U15.P$9 (VDD@6), U15.P$10 (VDD@7), U15.P$15 (VDD@8), U15.P$16 (VDD@9), U15.P$18 (VDD@10), U15.P$21 (VDD@11), U15.P$22 (VDD@12), U15.P$23 (VDD@13), U15.P$24 (VDD@14), U15.P$27 (VDD@15), U15.P$28 (VDD@16), U15.P$30 (VDD@17), U15.P$33 (VDD@18), U15.P$34 (VDD@19), U15.P$35 (VDD@20), U15.P$36 (VDD@21), U15.P$37 (VDD@22), U15.P$38 (VDD@23), U15.P$43 (VDD@24), U15.P$45 (VDD@25), U15.P$46 (VDD@26), U16.P$1 (VDD@1), U16.P$2 (VDD@2), U16.P$3 (VDD@3), U16.P$6 (VDD@4), U16.P$8 (VDD@5), U16.P$9 (VDD@6), U16.P$10 (VDD@7), U16.P$15 (VDD@8), U16.P$16 (VDD@9), U16.P$18 (VDD@10), U16.P$21 (VDD@11), U16.P$22 (VDD@12), U16.P$23 (VDD@13), U16.P$24 (VDD@14), U16.P$27 (VDD@15), U16.P$28 (VDD@16), U16.P$30 (VDD@17), U16.P$33 (VDD@18), U16.P$34 (VDD@19), U16.P$35 (VDD@20), U16.P$36 (VDD@21), U16.P$37 (VDD@22), U16.P$38 (VDD@23), U16.P$43 (VDD@24), U16.P$45 (VDD@25), U16.P$46 (VDD@26)

Notes on the sheet:
FAN
I2C BUS
USB
ICSP (pads)
