devilreraser/hw_crypto_miner_bitfury/BTF16_2_2/PADS/BTF16_2/SL_borders.ini

[SYMBOLS]
A0SHEETL=Borders:a0sheet.1
A0SHEETL1=Borders:a0sheet.1
A0SHEETP=Borders:a0sheet.2
A0SHEETP1=Borders:a0sheet.2
A1SHEETL=Borders:a1sheet.1
A1SHEETL1=Borders:a1sheet.1
A1SHEETP=Borders:a1sheet.2
A1SHEETP1=Borders:a1sheet.2
A2SHEETL=Borders:a2sheet.1
A2SHEETL1=Borders:a2sheet.1
A2SHEETP=Borders:a2sheet.2
A2SHEETP1=Borders:a2sheet.2
A3SHEETL=Borders:a3sheet.1
A3SHEETL1=Borders:a3sheet.1
A3SHEETP=Borders:a3sheet.2
A3SHEETP1=Borders:a3sheet.2
A4SHEETL=Borders:a4sheet.1
A4SHEETL1=Borders:a4sheet.1
A4SHEETP=Borders:a4sheet.2
A4SHEETP1=Borders:a4sheet.2
ASHEETL=Borders:asheet.1
ASHEETL1=Borders:asheet.1
ASHEETP=Borders:asheet.2
ASHEETP1=Borders:asheet.2
BSHEETL=Borders:bsheet.1
BSHEETL1=Borders:bsheet.1
BSHEETP=Borders:bsheet.2
BSHEETP1=Borders:bsheet.2
CSHEETL=Borders:csheet.1
CSHEETL1=Borders:csheet.1
CSHEETP=Borders:csheet.2
CSHEETP1=Borders:csheet.2
DSHEETL=Borders:dsheet.1
DSHEETL1=Borders:dsheet.1
DSHEETP=Borders:dsheet.2
DSHEETP1=Borders:dsheet.2
ESHEETL=Borders:esheet.1
ESHEETL1=Borders:esheet.1
ESHEETP=Borders:esheet.2
ESHEETP1=Borders:esheet.2
FSHEETL=Borders:fsheet.1
FSHEETL1=Borders:fsheet.1
FSHEETP=Borders:fsheet.2
FSHEETP1=Borders:fsheet.2
[ZONE A0SHEETL]
OFFSETLEFT=0
OFFSETRIGHT=399999
OFFSETTOP=100000
OFFSETBOTTOM=0
VERTNUMBER=8
HORZNUMBER=8
VERTLABELING=1
HORZLABELING=2
[ZONE A0SHEETP]
OFFSETLEFT=0
OFFSETRIGHT=100000
OFFSETTOP=400000
OFFSETBOTTOM=0
VERTNUMBER=8
HORZNUMBER=8
VERTLABELING=1
HORZLABELING=2
[ZONE A1SHEETL]
OFFSETLEFT=0
OFFSETRIGHT=100000
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
[ZONE FSHEETL]
OFFSETLEFT=0
OFFSETRIGHT=0
OFFSETTOP=0
OFFSETBOTTOM=0
VERTNUMBER=4
HORZNUMBER=4
VERTLABELING=1
HORZLABELING=0
[ZONE FSHEETP]
OFFSETLEFT=0
OFFSETRIGHT=0
OFFSETTOP=0
OFFSETBOTTOM=0
VERTNUMBER=4
HORZNUMBER=4
VERTLABELING=1
HORZLABELING=0
[ATTRIBUTES]
[ANNOTATIONS]
[DEFAULTS]
