devilreraser/hw_crypto_miner_bitfury/(commit log)

2024-01-20 added nano
    [Bill of Materials-NanoFury16.xlsx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]
2024-01-20 added klondike
    [K1 Parts List.ods, K16 Parts List.ods, Thermistor Lookup Table.ods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]
